kevinmcaleer/cyberpup/chihuahua/stl/snout_x1.stl

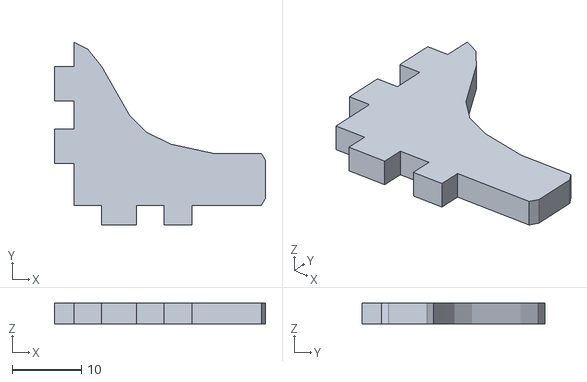
[picture p6: CAD file, 2026-09-25]
chihuahua/stl/snout_x1.stl
30.4 x 26.3 x 3.00
