kevinmcaleer/cyberpup/chihuahua/stl/muzzle_x1.stl

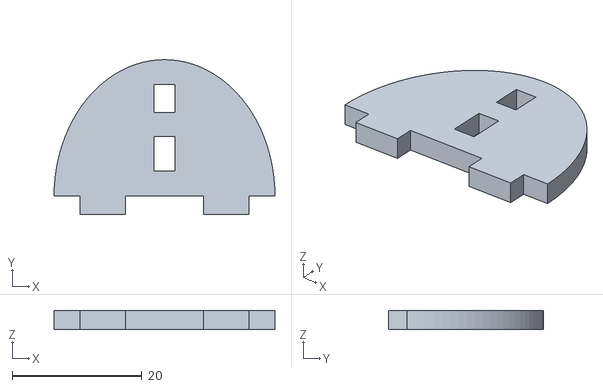
[picture p7: CAD file, 2026-09-25]
chihuahua/stl/muzzle_x1.stl
34.0 x 23.8 x 3.00
