kevinmcaleer/cyberpup/chihuahua/stl/base_x1.stl

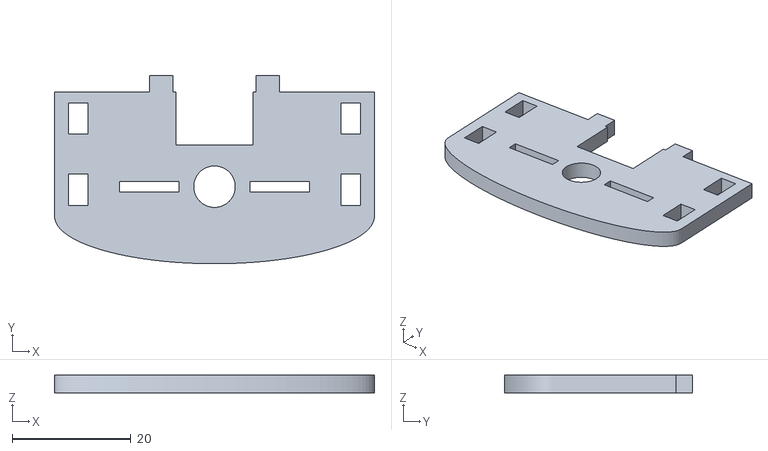
[picture p8: CAD file, 2026-09-25]
chihuahua/stl/base_x1.stl
54.0 x 31.8 x 3.00
