kevinmcaleer/cyberpup/chihuahua/stl/nose_x1.stl

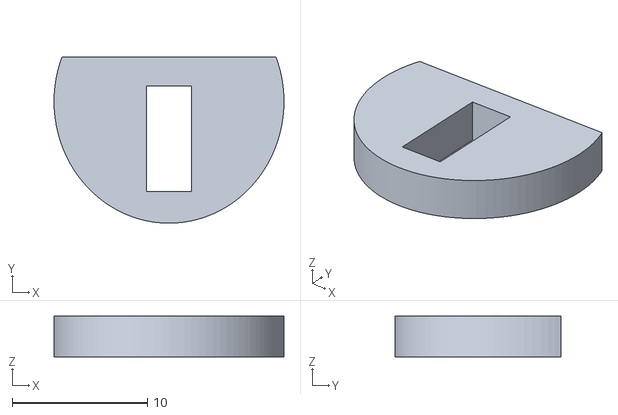
[picture p9: CAD file, 2026-09-25]
chihuahua/stl/nose_x1.stl
17.0 x 12.3 x 3.00
