kevinmcaleer/cyberpup/chihuahua/stl/crown_x1.stl

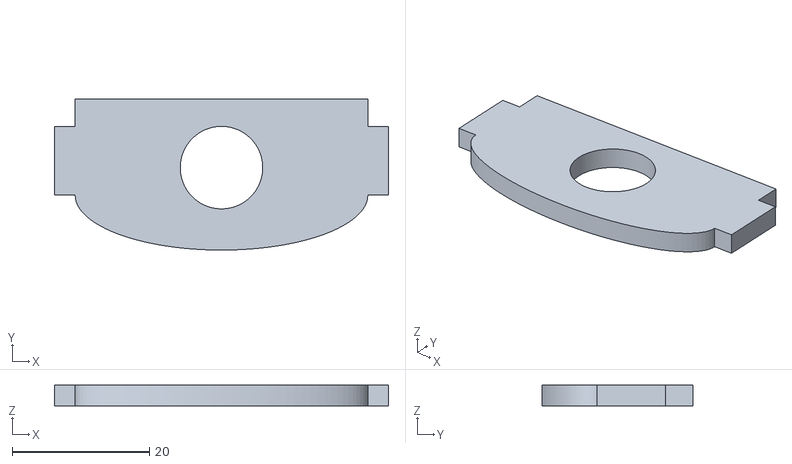
[picture p10: CAD file, 2026-09-25]
chihuahua/stl/crown_x1.stl
48.6 x 22.0 x 3.00
