kevinmcaleer/cyberpup/chihuahua/stl/side_x2.stl

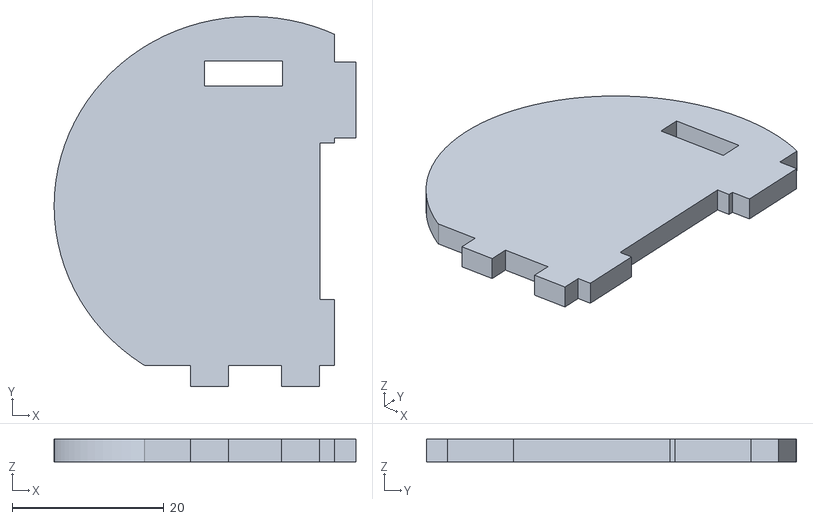
[picture p11: CAD file, 2026-09-25]
chihuahua/stl/side_x2.stl
39.8 x 48.8 x 3.00
