kevinmcaleer/cyberpup/chihuahua/stl/face_x1.stl

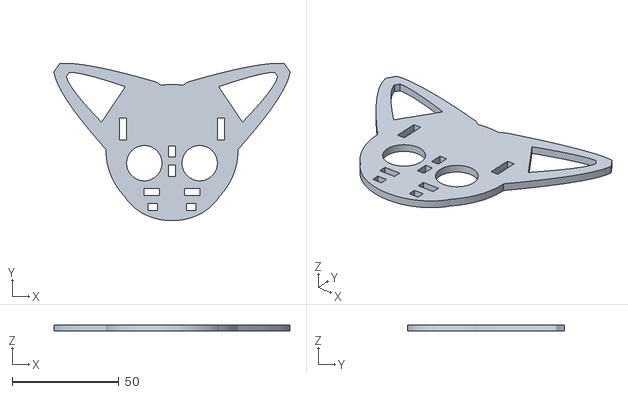
[picture p12: CAD file, 2026-09-25]
chihuahua/stl/face_x1.stl
110.8 x 73.9 x 3.00
