kevinmcaleer/cyberpup/chihuahua/stl/eye_ring_x2.stl

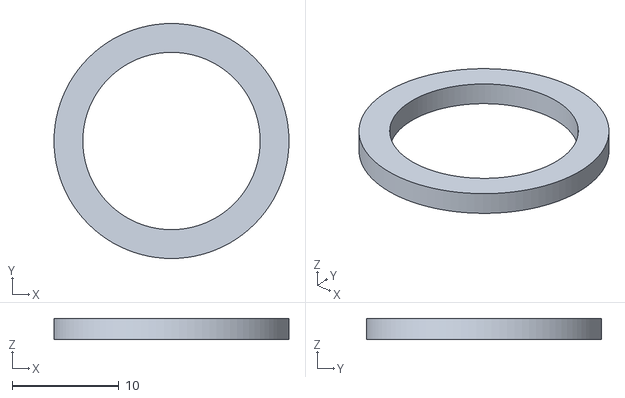
[picture p13: CAD file, 2026-09-25]
chihuahua/stl/eye_ring_x2.stl
22.0 x 22.0 x 2.00
