kevinmcaleer/cyberpup/(list of files, cad)

Other CAD files:
chihuahua/chihuahua_head.blend
chihuahua/dxf/base_x1.dxf
chihuahua/dxf/crown_x1.dxf
chihuahua/dxf/eye_ring_x2.dxf
chihuahua/dxf/face_x1.dxf
chihuahua/dxf/muzzle_x1.dxf
chihuahua/dxf/nose_x1.dxf
chihuahua/dxf/side_x2.dxf
chihuahua/dxf/snout_x1.dxf
